Charles-cad/C3I_A25_CardPCB/Remise/Projet KICAD/Photos on PCB/cat.jpeg

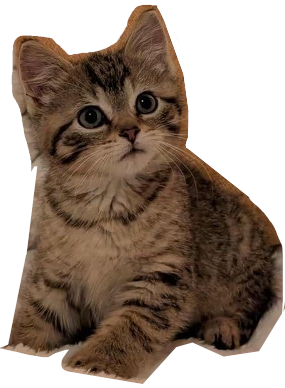
Remise/Projet KICAD/Photos on PCB/cat.jpeg
