Charles-cad/C3I_A25_CardPCB/elec/PCB/CardPCB/Photos on PCB/github_qr.png

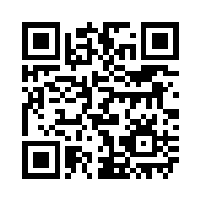
elec/PCB/CardPCB/Photos on PCB/github_qr.png
