Charles-cad/C3I_A25_CardPCB/github_qr_1.png

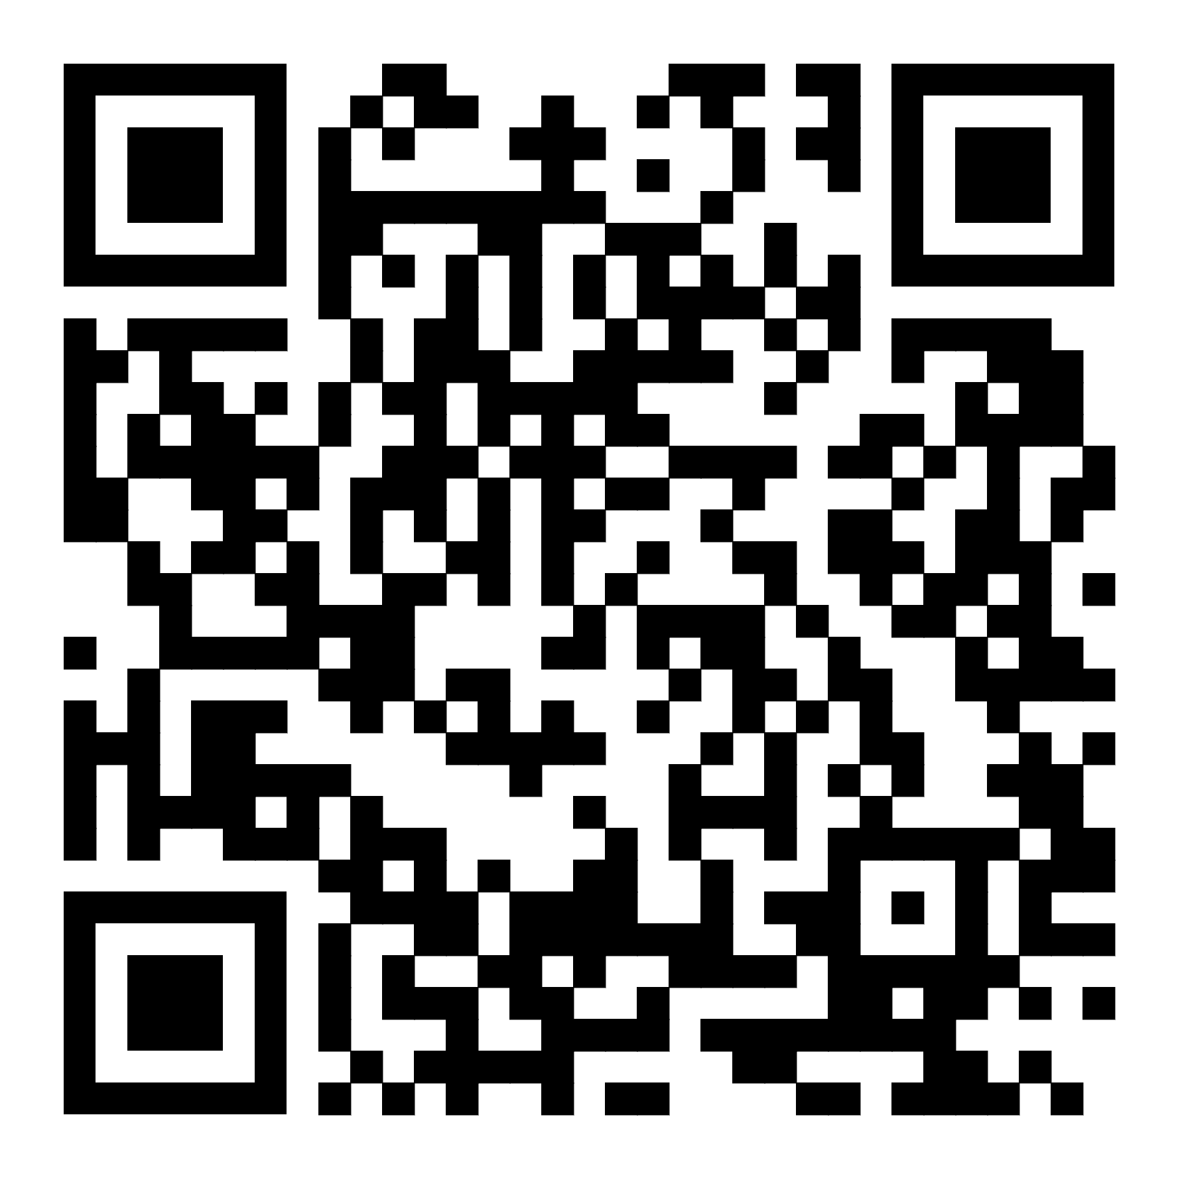
github_qr_1.png
