Charles-cad/C3I_A25_CardPCB/Remise/Projet KICAD/OSTTE020104/OSTTE020104.step

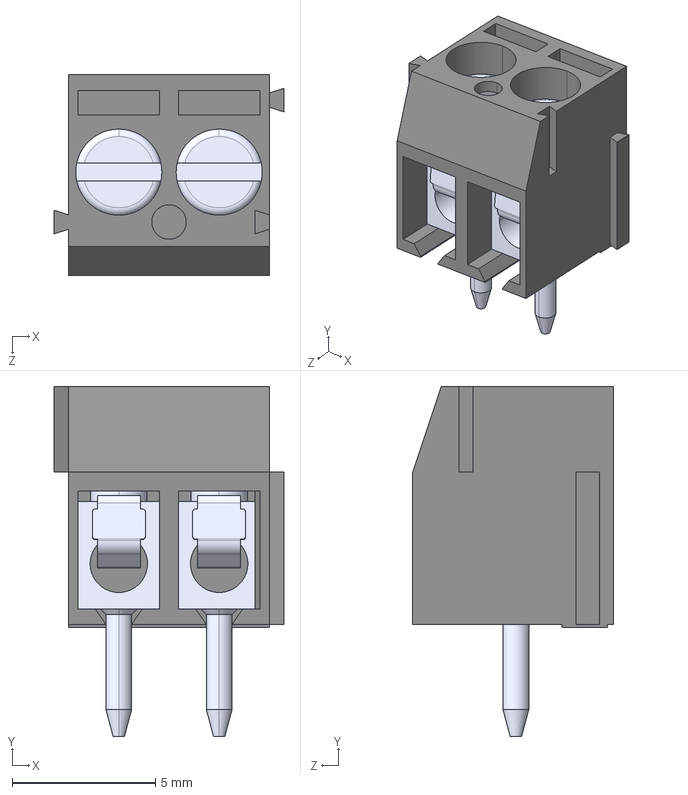
[picture p18: CAD file, 2025-11-20]
Remise/Projet KICAD/OSTTE020104/OSTTE020104.step
8.00 x 12.2 x 7.00 mm
