Charles-cad/C3I_A25_CardPCB/Remise/Schéma_elect.pdf

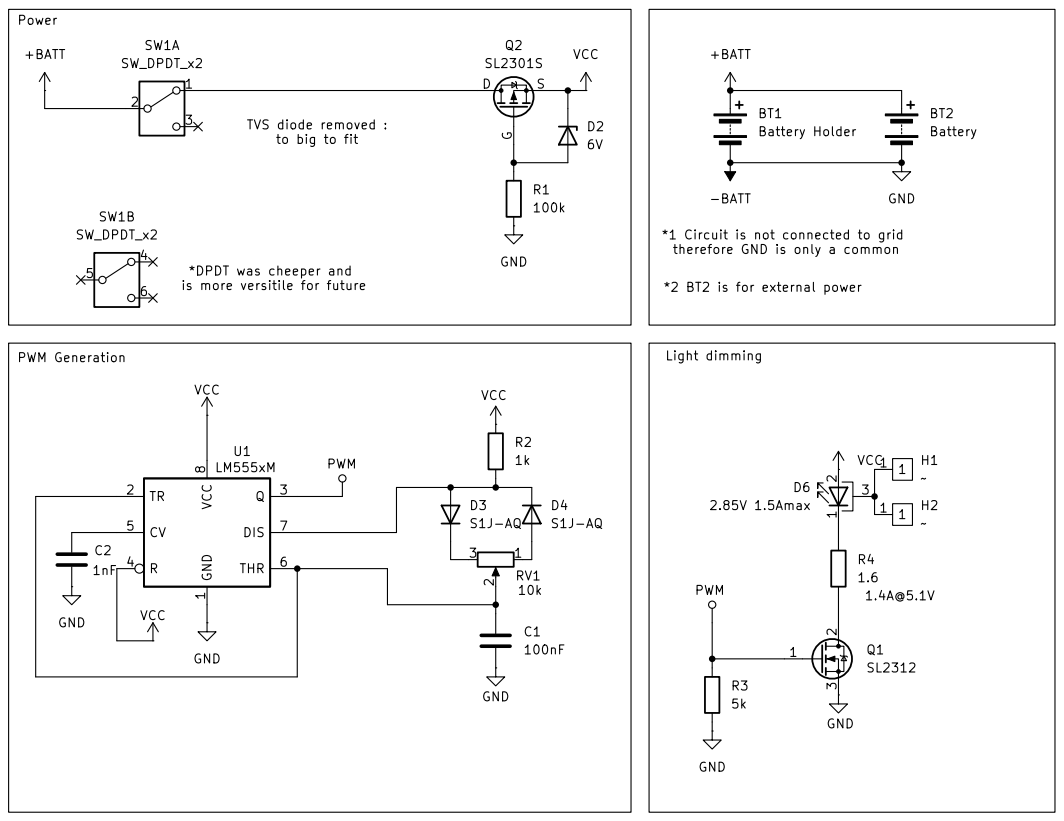
[picture p19: page 1]
