Charles-cad/C3I_A25_CardPCB/elec/PCB/CardPCB/CardPCB.kicad_sch

## KiCad design elec/PCB/CardPCB/CardPCB.kicad_sch (2026-01-03)


Parts:
BT1: Battery Holder; BAT_2479
BT2: Battery; 2 pin screw connector
C1: 100nF; C_0805_2012Metric
C2: 1nF; C_0805_2012Metric
D2: 6V; D_SOD-123
D3, D4: S1J-AQ; D_SMB_Handsoldering
D6: 2.85V 1.5Amax; LED_Cree-XHP50_3V_HighDensity
H1, H2: Heatsink
Q1: SL2312; TSOT-23_HandSoldering
Q2: SL2301S; TSOT-23
R1: 100k; R_0805_2012Metric_Pad1.20x1.40mm_HandSolder
R2: 1k; R_0805_2012Metric_Pad1.20x1.40mm_HandSolder
R3: 5k; R_1206_3216Metric_Pad1.30x1.75mm_HandSolder
R4: 1.6; R_1206_3216Metric_Pad1.30x1.75mm_HandSolder
RV1: 10k; Potentiometer_Bourns_TC33X_Vertical
SW1: SW_DPDT_x2; DPDT
U1: LM555xM; SOIC-8_3.9x4.9mm_P1.27mm

Connections:
+BATT: BT1.1 (+), BT2.1 (+), SW1.2 (B)
-BATT: BT1.2 (-), BT2.2 (-), C1.2, C2.2, Q1.3 (S), R1.2, R3.2, U1.1 (GND)
unnamed: C1.1, RV1.2, U1.2 (TR), U1.6 (THR)
unnamed: C2.1, U1.5 (CV)
unnamed: D2.2 (A), Q2.2 (G), R1.1
unnamed: D3.1 (K), RV1.3
unnamed: D3.2 (A), D4.1 (K), R2.2, U1.7 (DIS)
unnamed: D4.2 (A), RV1.1
unnamed: D6.1 (K), R4.1
unnamed: D6.3 (PAD), H1.1, H2.1
unnamed: Q1.1 (G), R3.1
unnamed: Q1.2 (D), R4.2
unnamed: Q2.1 (D), SW1.1 (A)
VCC: D2.1 (K), D6.2 (A), Q2.3 (S), R2.1, U1.4 (R), U1.8 (VCC)

Notes on the sheet:
1.4A@5.1V
*1 Circuit is not connected to grid therefore GND is only a common
Light dimming
TVS diode removed : to big to fit
Power
*DPDT was cheeper and is more versitile for future
PWM Generation
*2 BT2 is for external power
