Charles-cad/C3I_A25_CardPCB/(commit log)

2025-11-20 so many changes
    [CardPCB.kicad_pcb, CardPCB.kicad_sch, OSTTE020104.step, Power_Circuit.kicad_sch]
2025-11-29 Final PCB
    Generation of gerber and sending command
    [CardPCB.kicad_pcb, CardPCB.kicad_sch]
2025-11-29 added ground plane and fix qr code
    [CardPCB.kicad_pcb]
2025-12-28 Added digikey order
    [CardPCB.kicad_pcb]
2026-01-03 Dossier de remise
    voila
    [BOM.csv, CardPCB.csv, CardPCB.kicad_pcb, CardPCB.kicad_sch, OSTTE020104.step, Power_Circuit.kicad_sch]
2026-01-03 Gerber dans fichier de remise
    [CardPCB.GBL, CardPCB.GBO, CardPCB.GBP, CardPCB.GBS, CardPCB.GKO, CardPCB.GTL, CardPCB.GTO, CardPCB.GTP]
